losredoe132/h43it/hardware/h43it_micro/h43bit_micro.kicad_pcb

## KiCad design hardware/h43it_micro/h43bit_micro.kicad_pcb (2024-03-31)

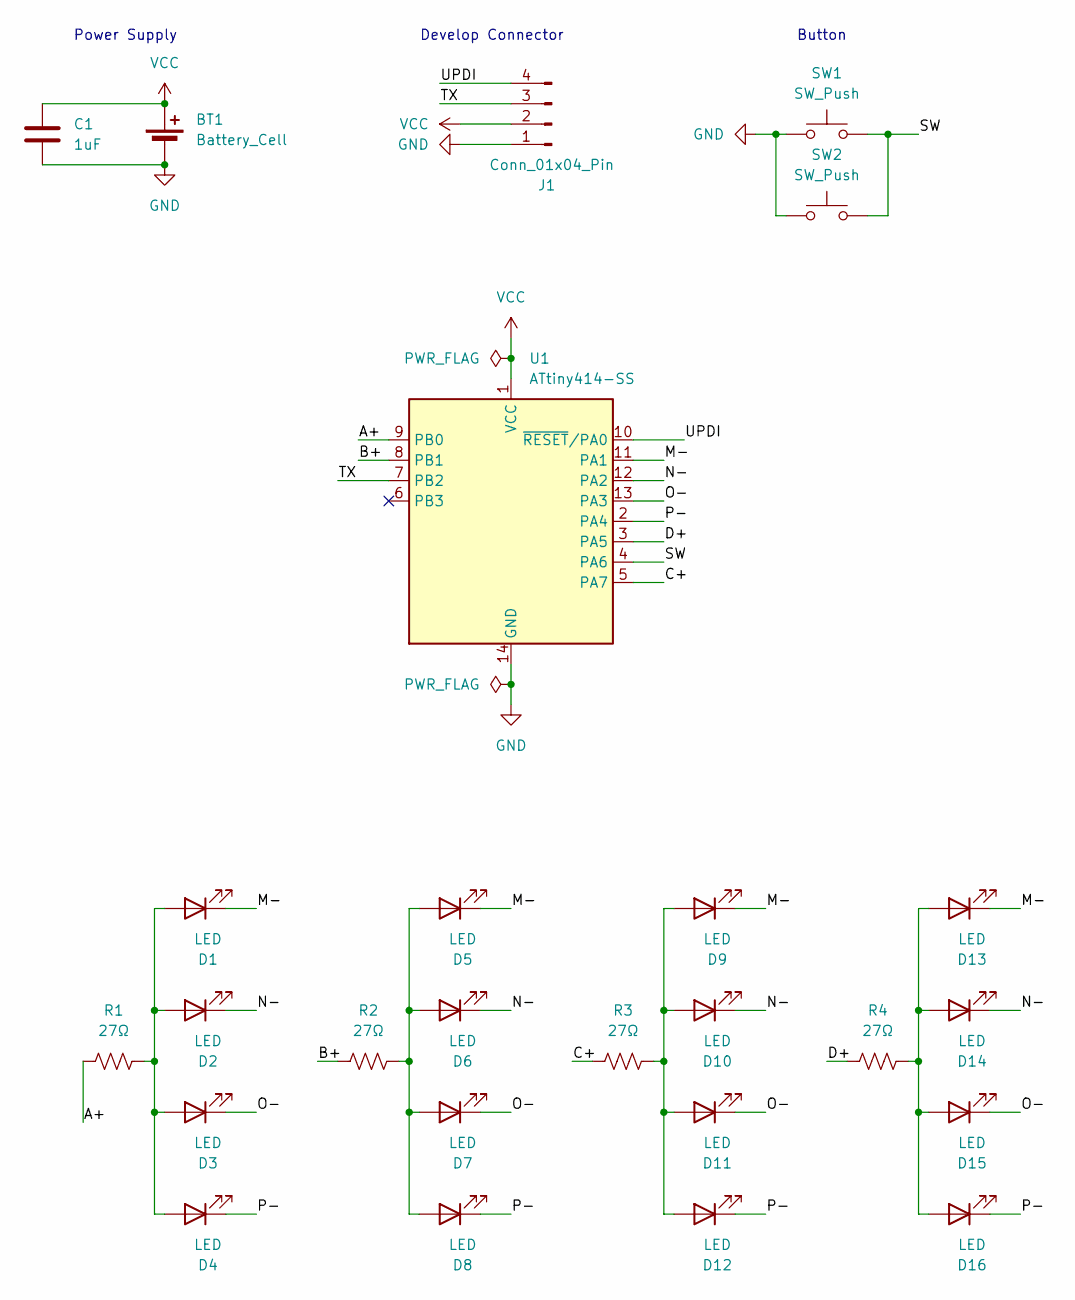
[picture p1: schematic h43bit_micro.kicad_sch]

Parts:
BT1: Battery_Cell; BAT-HLD-001
C1: 1uF; C_0805_2012Metric
D1, D2, D3, D4, D5, D6, D7, D8, D9, D10, D11, D12, D13, D14, D15, D16: LED; LED_0805_2012Metric
J1: Conn_01x04_Pin; PinHeader_1x04_P2.54mm_Vertical
R1, R2, R3, R4: 27Ω; R_0805_2012Metric
SW1: SW_Push; PTS526 SM15 SMTR2 LFS
SW2: SW_Push; FSM2JSMAATR
U1: ATtiny414-SS; SOIC-14_3.9x8.7mm_P1.27mm

Connections:
/A+: R1.1, U1.9 (PB0)
/B+: R2.1, U1.8 (PB1)
/C+: R3.1, U1.5 (PA7)
/D+: R4.1, U1.3 (PA5)
/M-: D1.1 (K), D5.1 (K), D9.1 (K), D13.1 (K), U1.11 (PA1)
/N-: D2.1 (K), D6.1 (K), D10.1 (K), D14.1 (K), U1.12 (PA2)
/O-: D3.1 (K), D7.1 (K), D11.1 (K), D15.1 (K), U1.13 (PA3)
/P-: D4.1 (K), D8.1 (K), D12.1 (K), D16.1 (K), U1.2 (PA4)
/SW: SW1.2, SW2.2, U1.4 (PA6)
/TX: J1.3, U1.7 (PB2)
/UPDI: J1.4, U1.10 (~RESET/PA0)
GND: BT1.2 (-), C1.2, J1.1, SW1.1, SW2.1, U1.14 (GND)
unnamed: D1.2 (A), D2.2 (A), D3.2 (A), D4.2 (A), R1.2
unnamed: D5.2 (A), D6.2 (A), D7.2 (A), D8.2 (A), R2.2
unnamed: D9.2 (A), D10.2 (A), D11.2 (A), D12.2 (A), R3.2
unnamed: D13.2 (A), D14.2 (A), D15.2 (A), D16.2 (A), R4.2
VCC: BT1.1 (+), C1.1, J1.2, U1.1 (VCC)

Notes on the sheet:
Develop Connector
Power Supply
Button

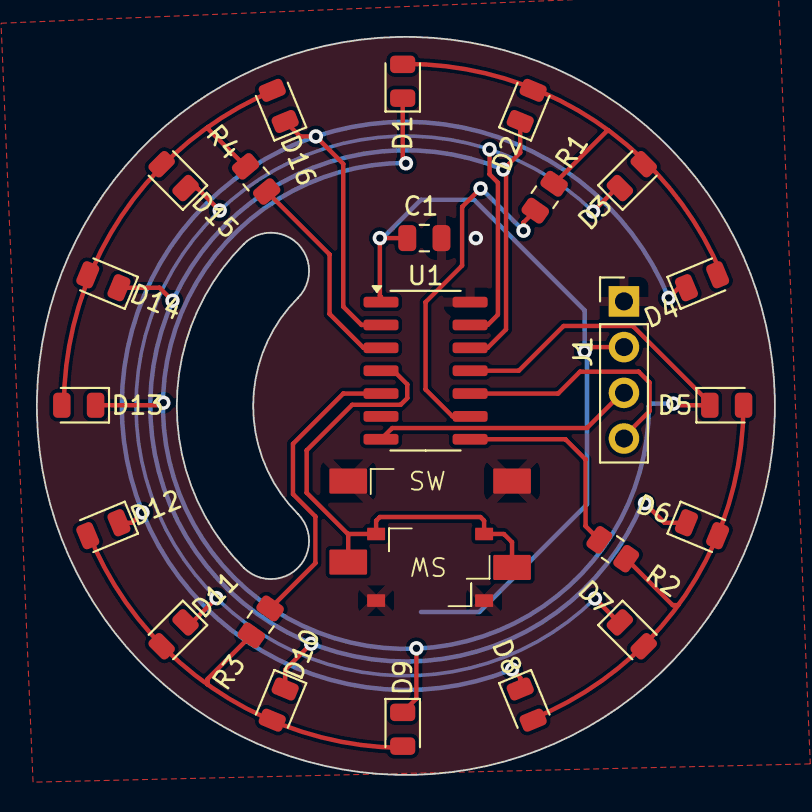
[picture p2: board h43bit_micro.kicad_pcb from above]

Board: 2 copper layers, 41.0 x 41.0 mm, 26 parts (1 on the bottom side), 17 nets.
