losredoe132/h43it/hardware/h43it_macro/h43it_macro.kicad_pcb

## KiCad design hardware/h43it_macro/h43it_macro.kicad_pcb (2024-03-28)

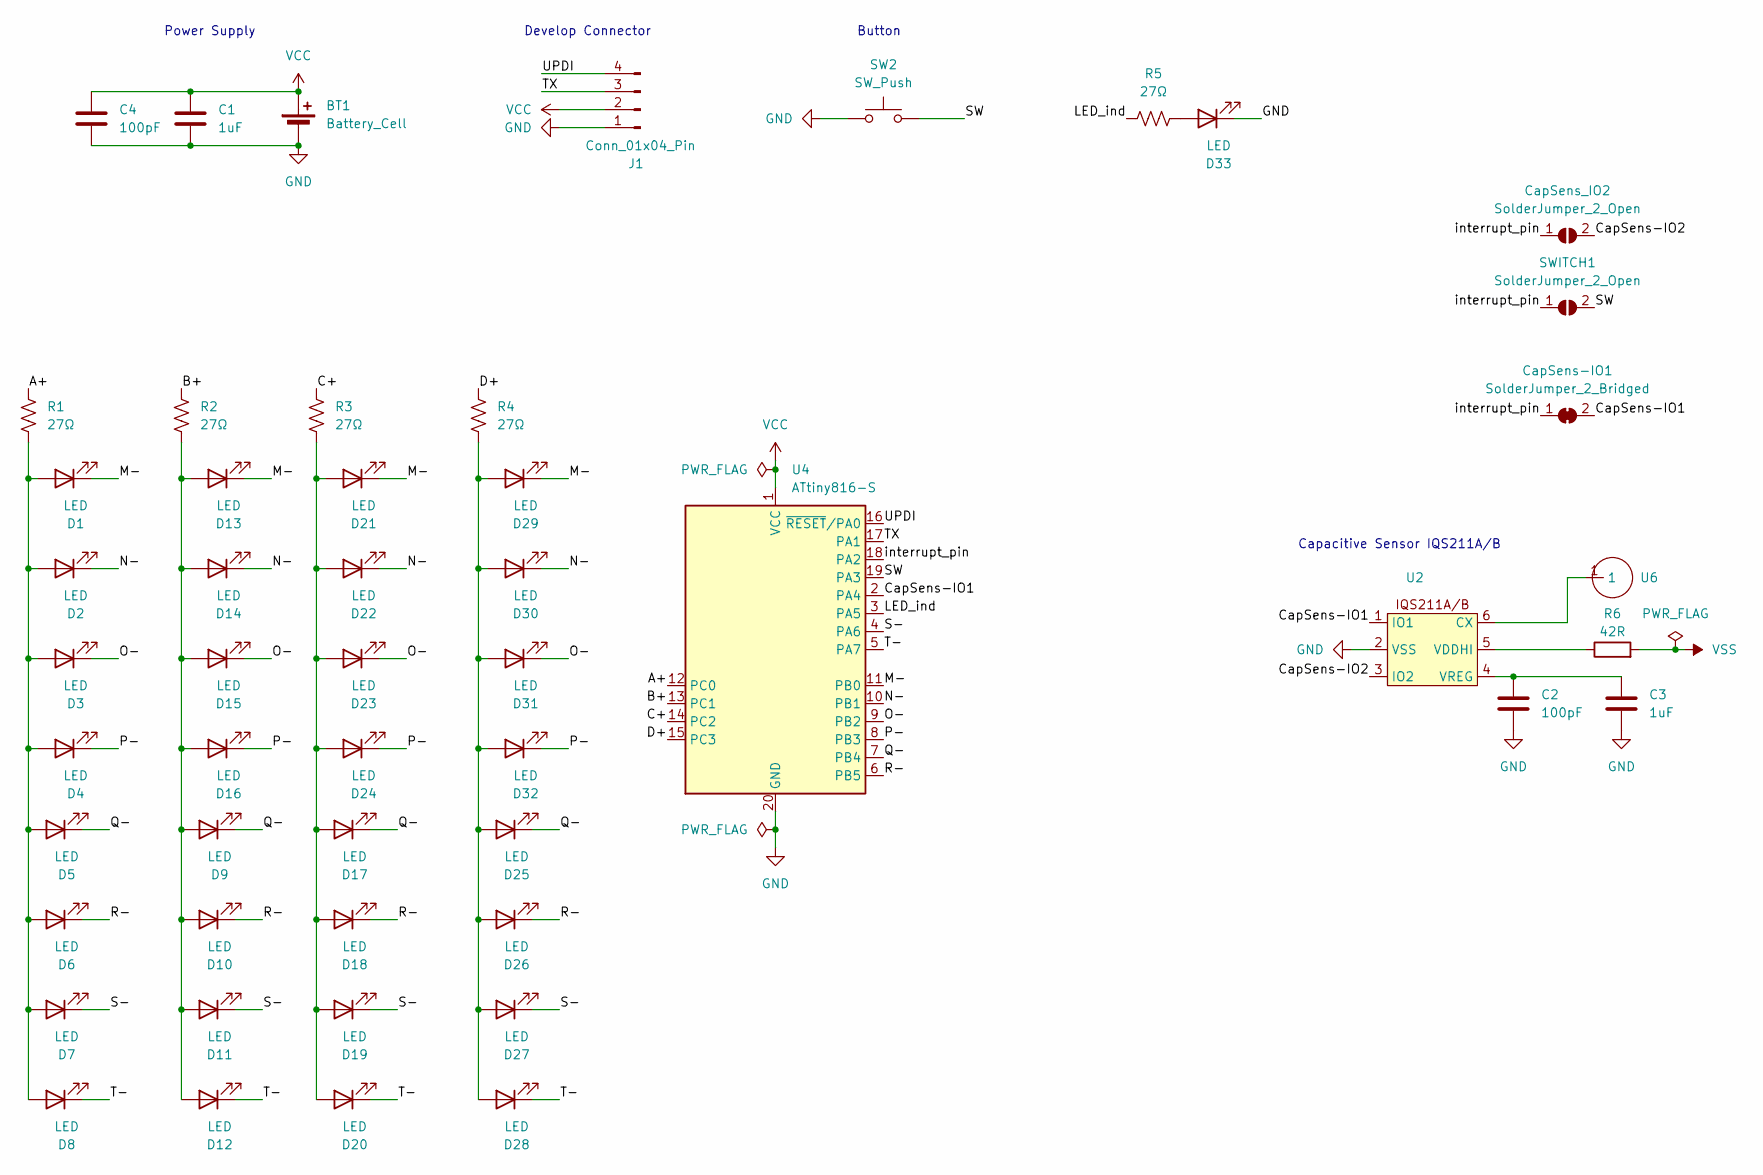
[picture p3: schematic h43it_macro.kicad_sch]

Parts:
BT1: Battery_Cell; Battery_holder__Keystone_Electronic_AA_2462
C1, C3: 1uF; C_0805_2012Metric
C2, C4: 100pF; C_0805_2012Metric
CapSens-IO1: SolderJumper_2_Bridged; SolderJumper-2_P1.3mm_Bridged_RoundedPad1.0x1.5mm
CapSens_IO2: SolderJumper_2_Open; SolderJumper-2_P1.3mm_Open_RoundedPad1.0x1.5mm
D1, D2, D3, D4, D5, D6, D7, D8, D9, D10, D11, D12, D13, D14, D15, D16, D17, D18, D19, D20, D21, D22, D23, D24, D25, D26, D27, D28, D29, D30, D31, D32, D33: LED; LED_0805_2012Metric
J1: Conn_01x04_Pin; PinHeader_1x04_P2.54mm_Vertical
R1, R2, R3, R4, R5: 27Ω; R_0805_2012Metric
R6: 42R; R_0805_2012Metric
SW2: SW_Push; FSM2JSMAATR
SWITCH1: SolderJumper_2_Open; SolderJumper-2_P1.3mm_Open_RoundedPad1.0x1.5mm
U2: TSOT32-6
U4: ATtiny816-S; SOIC-20W_7.5x12.8mm_P1.27mm
U6: TouchButton-15x10mm

Connections:
/A+: R1.2, U4.12 (PC0)
/B+: R2.2, U4.13 (PC1)
/C+: R3.2, U4.14 (PC2)
/CapSens-IO1: CapSens-IO1.2 (B), U2.1 (IO1), U4.2 (PA4)
/CapSens-IO2: CapSens_IO2.2 (B), U2.3 (IO2)
/D+: R4.2, U4.15 (PC3)
/LED_ind: R5.2, U4.3 (PA5)
/M-: D1.1 (K), D13.1 (K), D21.1 (K), D29.1 (K), U4.11 (PB0)
/N-: D2.1 (K), D14.1 (K), D22.1 (K), D30.1 (K), U4.10 (PB1)
/O-: D3.1 (K), D15.1 (K), D23.1 (K), D31.1 (K), U4.9 (PB2)
/P-: D4.1 (K), D16.1 (K), D24.1 (K), D32.1 (K), U4.8 (PB3)
/Q-: D5.1 (K), D9.1 (K), D17.1 (K), D25.1 (K), U4.7 (PB4)
/R-: D6.1 (K), D10.1 (K), D18.1 (K), D26.1 (K), U4.6 (PB5)
/S-: D7.1 (K), D11.1 (K), D19.1 (K), D27.1 (K), U4.4 (PA6)
/SW: SW2.2, SWITCH1.2 (B), U4.19 (PA3)
/T-: D8.1 (K), D12.1 (K), D20.1 (K), D28.1 (K), U4.5 (PA7)
/TX: J1.3, U4.17 (PA1)
/UPDI: J1.4, U4.16 (~RESET/PA0)
/interrupt_pin: CapSens-IO1.1 (A), CapSens_IO2.1 (A), SWITCH1.1 (A), U4.18 (PA2)
GND: BT1.2 (-), C1.2, C2.2, C3.2, C4.2, D33.1 (K), J1.1, SW2.1, U2.2 (VSS), U4.20 (GND)
unnamed: D1.2 (A), D2.2 (A), D3.2 (A), D4.2 (A), D5.2 (A), D6.2 (A), D7.2 (A), D8.2 (A), R1.1
unnamed: D9.2 (A), D10.2 (A), D11.2 (A), D12.2 (A), D13.2 (A), D14.2 (A), D15.2 (A), D16.2 (A), R2.1
unnamed: D17.2 (A), D18.2 (A), D19.2 (A), D20.2 (A), D21.2 (A), D22.2 (A), D23.2 (A), D24.2 (A), R3.1
unnamed: D25.2 (A), D26.2 (A), D27.2 (A), D28.2 (A), D29.2 (A), D30.2 (A), D31.2 (A), D32.2 (A), R4.1
unnamed: D33.2 (A), R5.1
unnamed: U2.6 (CX), U6.1
unnamed: R6.1, U2.5 (VDDHI)
unnamed: C2.1, C3.1, U2.4 (VREG)
VCC: BT1.1 (+), C1.1, C4.1, J1.2, U4.1 (VCC)
VSS: R6.2

Notes on the sheet:
Button
Power Supply
Capacitive Sensor IQS211A/B
Develop Connector

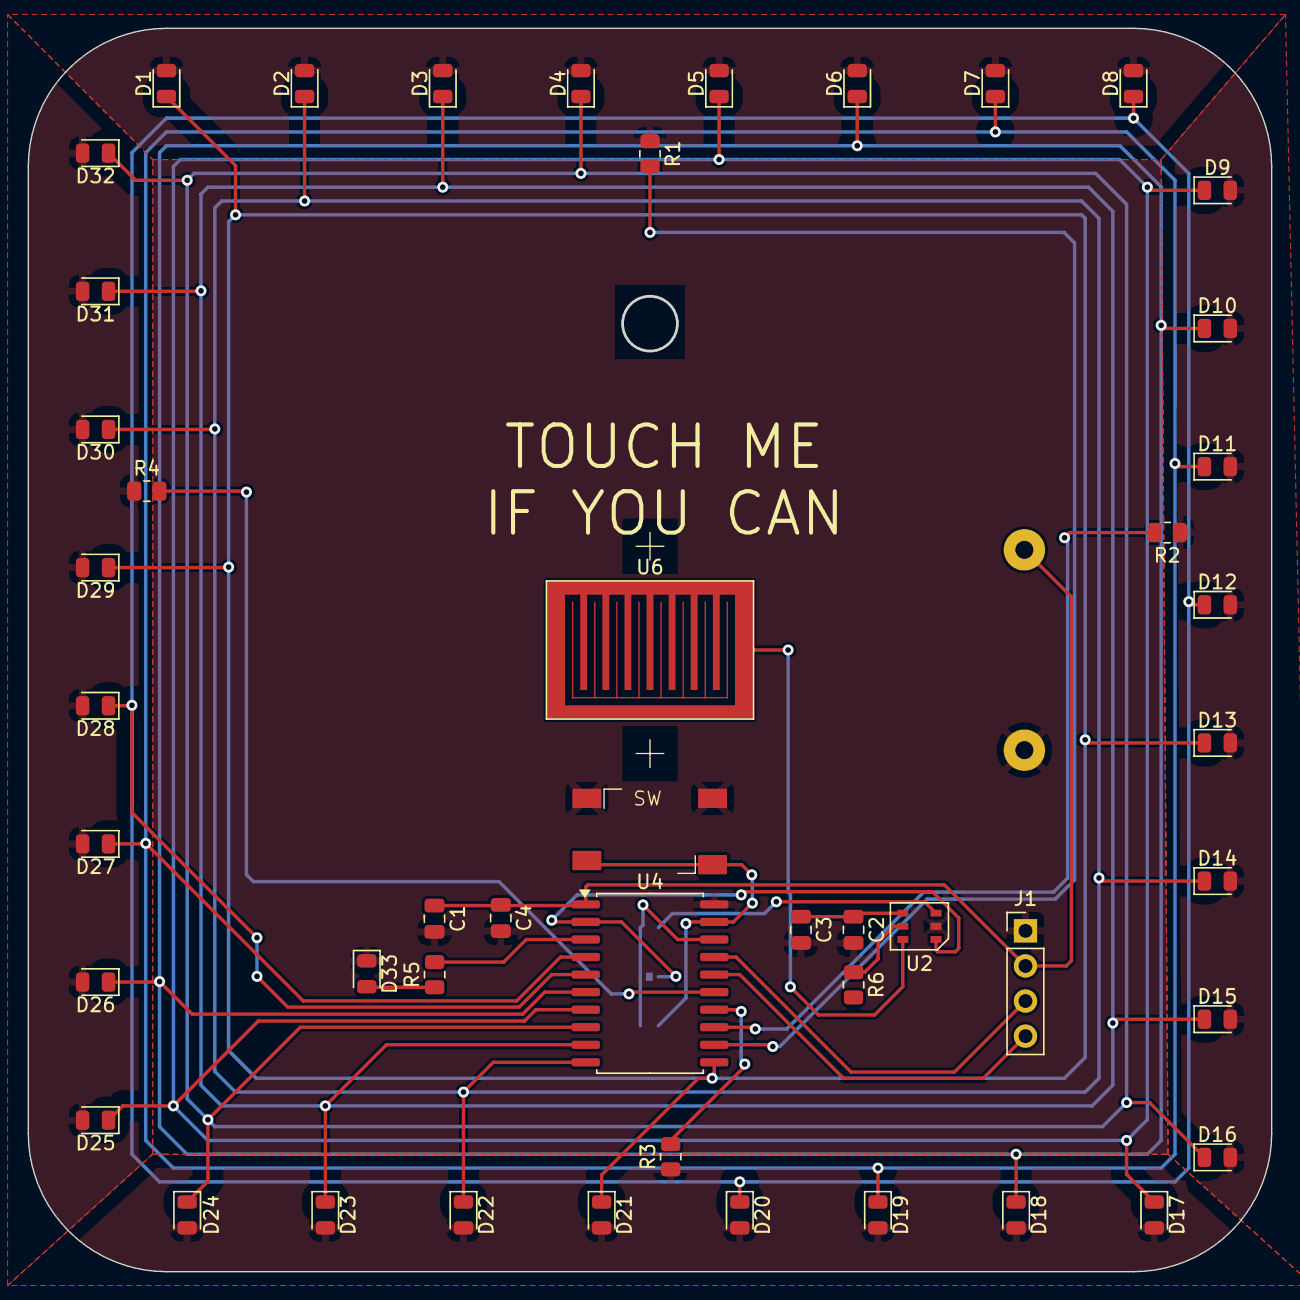
[picture p4: board h43it_macro.kicad_pcb from above]

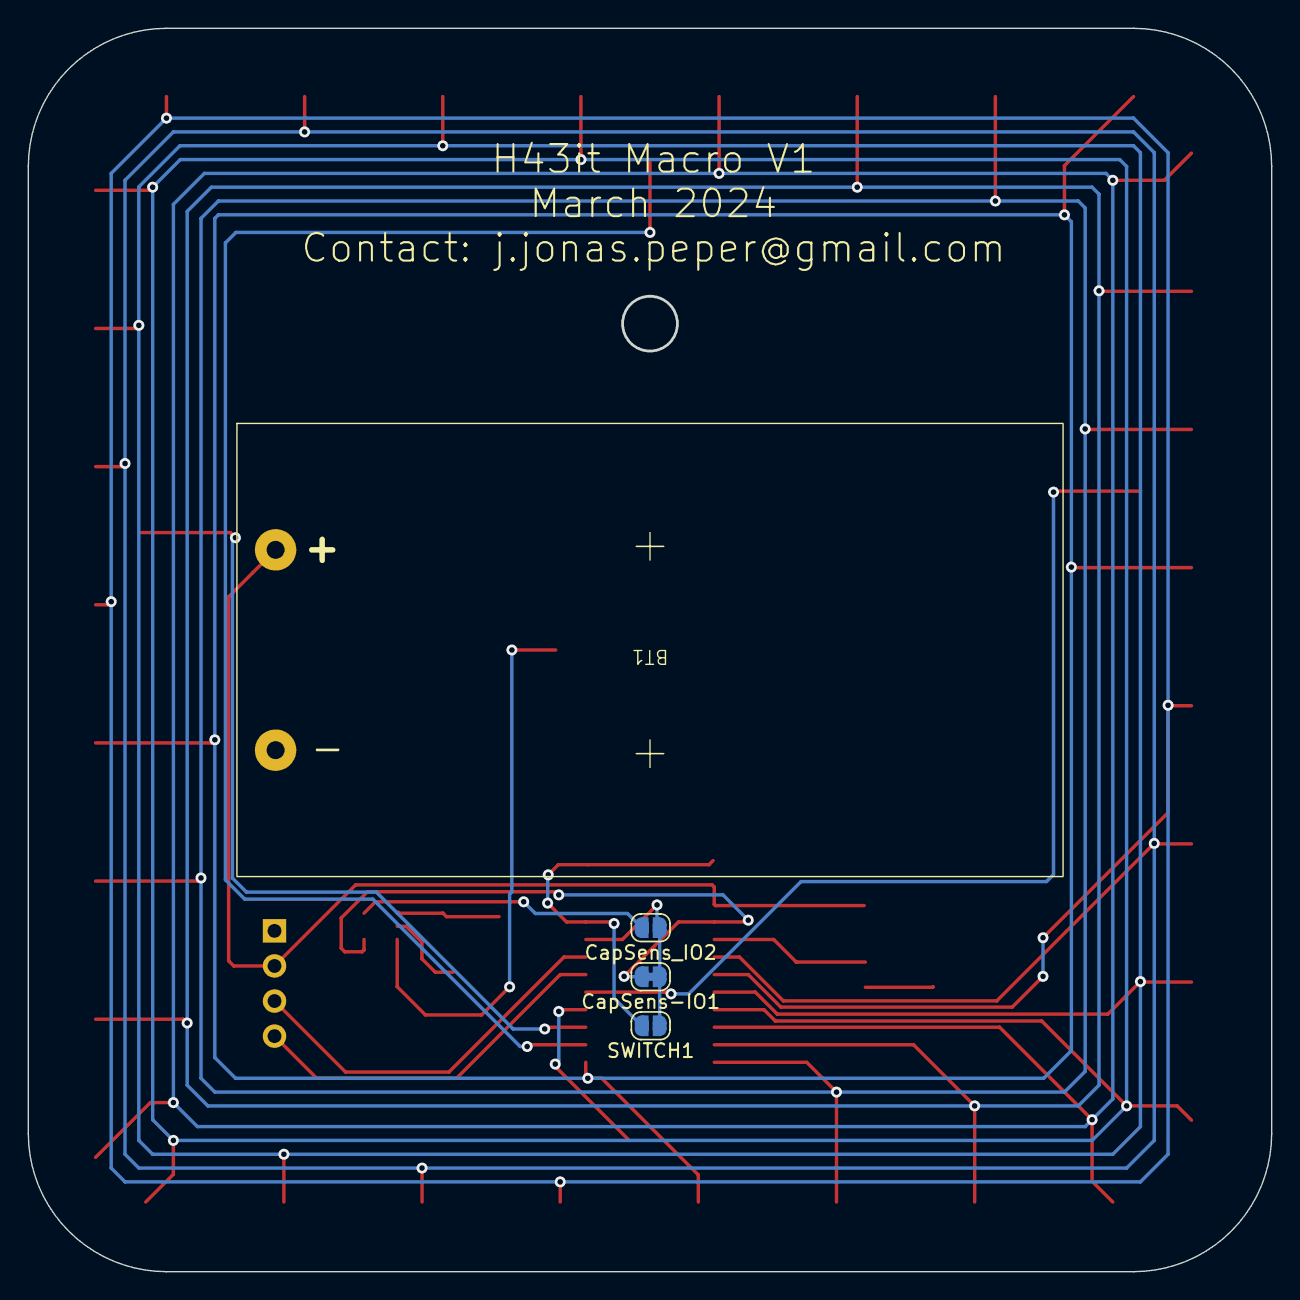
[picture p5: board h43it_macro.kicad_pcb from below]

Board: 2 copper layers, 90.0 x 90.0 mm, 52 parts (4 on the bottom side), 29 nets.
