losredoe132/h43it/(threads)

Thread 1 (2024-03-28):

add light_on variable

losredoe132, 2024-03-28:
the ISR for the RTC triggers a wake up approx. every 30s. This leads to a very short blink and sometimes to one LED remain on even if the µC is going to sleep.
Introduce a variable that prevents the LEDs from going on everytime the µC is awake.

Thread 3 (2024-07-29):

Use the status LED

losredoe132, 2024-07-29:
- solder resistor and LED
- implement RESET LED
