losredoe132/h43it/software/macro/GccApplication5/include/transition_conditions.c

bool pred_button_push_long()
{
	if (consecutive_counts_pressed > 100)
	{
		return true;
	}
	else
	{
		return false;
	}
}

bool pred_button_push_short()
{
	if (consecutive_counts_pressed > 2)
	{
		return true;
	}
	else
	{
		return false;
	}
}

bool pred_button_released()
{
	if (consecutive_counts_released > 2)
	{
		return true;
	}
	else
	{
		return false;
	}
}

bool pred_tired()
{
	if (n_counts_awake > 50)
	{
		return true;
	}
	else
	{
		return false;
	}
}

bool pred_true()
{
	return true;
}

bool pred_ISRs()
{
	// This is not an actual condition but handled by the Interrupt Service Routines to be
	// wake up from sleep if a button gets pressed or the Periodic Interrupt Routine is firing.
	return true;
}

bool pred_is_PIT_ISR()
{
	if (is_PIT_ISR == 1)
	{
		return true;
	}
	else
	{
		return false;
	}
}

bool pred_is_button_ISR()
{
	if (is_PIT_ISR == 0)
	{
		return true;
	}
	else
	{
		return false;
	}
}
