losredoe132/h43it/software/macro/GccApplication5/include/transition_table.c

State  Activation ,   GoingToBed ,   Idle ,   Init ,   JustWokeUp ,   PIT ,   Reset ,   WaitUntilRelease  ;

// Define transitions for each state

Transition ActivationTransitions[] = {
    
    { &Idle, pred_button_released} ,  
    
    { &Reset, pred_button_push_long}  
    
};
Transition GoingToBedTransitions[] = {
    
    { &JustWokeUp, pred_ISRs}  
    
};
Transition IdleTransitions[] = {
    
    { &Activation, pred_button_push_short} ,  
    
    { &GoingToBed, pred_tired} ,  
    
    { &Idle, pred_true}  
    
};
Transition InitTransitions[] = {
    
    { &Reset, pred_button_released}  
    
};
Transition JustWokeUpTransitions[] = {
    
    { &WaitUntilRelease, pred_is_button_ISR} ,  
    
    { &PIT, pred_is_PIT_ISR}  
    
};
Transition PITTransitions[] = {
    
    { &GoingToBed, pred_true}  
    
};
Transition ResetTransitions[] = {
    
    { &Idle, pred_button_released}  
    
};
Transition WaitUntilReleaseTransitions[] = {
    
    { &Idle, pred_button_released}  
    
};

// Define states with transitions

State Activation = { "Activation", ActivationAction, ActivationTransitions, 2 };

State GoingToBed = { "GoingToBed", GoingToBedAction, GoingToBedTransitions, 1 };

State Idle = { "Idle", IdleAction, IdleTransitions, 3 };

State Init = { "Init", InitAction, InitTransitions, 1 };

State JustWokeUp = { "JustWokeUp", JustWokeUpAction, JustWokeUpTransitions, 2 };

State PIT = { "PIT", PITAction, PITTransitions, 1 };

State Reset = { "Reset", ResetAction, ResetTransitions, 1 };

State WaitUntilRelease = { "WaitUntilRelease", WaitUntilReleaseAction, WaitUntilReleaseTransitions, 1 };
