losredoe132/h43it/software/macro/GccApplication5/include/led_pins.c

const uint8_t port_a_b_c_outs[33][3] = {
	// TSxxxxxx,0bxxRQPONM, 0bxxxxDCBA
	{0b11000000, 0b00111111, 0b00000000}, // ALL OFF

	{0b11000000, 0b11111110, 0b00000001},
	{0b11000000, 0b11111101, 0b00000001},
	{0b11000000, 0b11111011, 0b00000001},
	{0b11000000, 0b11110111, 0b00000001},
	{0b11000000, 0b11101111, 0b00000001},
	{0b11000000, 0b11011111, 0b00000001},
	{0b10000000, 0b11111111, 0b00000001},
	{0b01000000, 0b11111111, 0b00000001},

	{0b11000000, 0b11101111, 0b00000010},
	{0b11000000, 0b11011111, 0b00000010},
	{0b10000000, 0b11111111, 0b00000010},
	{0b01000000, 0b11111111, 0b00000010},
	{0b11000000, 0b11111110, 0b00000010},
	{0b11000000, 0b11111101, 0b00000010},
	{0b11000000, 0b11111011, 0b00000010},
	{0b11000000, 0b11110111, 0b00000010},

	{0b11000000, 0b11101111, 0b00000100},
	{0b11000000, 0b11011111, 0b00000100},
	{0b10000000, 0b11111111, 0b00000100},
	{0b01000000, 0b11111111, 0b00000100},
	{0b11000000, 0b11111110, 0b00000100},
	{0b11000000, 0b11111101, 0b00000100},
	{0b11000000, 0b11111011, 0b00000100},
	{0b11000000, 0b11110111, 0b00000100},

	{0b11000000, 0b11101111, 0b00001000},
	{0b11000000, 0b11011111, 0b00001000},
	{0b10000000, 0b11111111, 0b00001000},
	{0b01000000, 0b11111111, 0b00001000},
	{0b11000000, 0b11111110, 0b00001000},
	{0b11000000, 0b11111101, 0b00001000},
	{0b11000000, 0b11111011, 0b00001000},
	{0b11000000, 0b11110111, 0b00001000},

};

void LEDOnById(int i)
{
	PORTA.OUT = port_a_b_c_outs[i][0];
	PORTB.OUT = port_a_b_c_outs[i][1];
	PORTC.OUT = port_a_b_c_outs[i][2];
}

void allLEDoff()
{
	PORTA.OUT = port_a_b_c_outs[0][0];
	PORTB.OUT = port_a_b_c_outs[0][1];
	PORTC.OUT = port_a_b_c_outs[0][2];
}


void statusLEDon(){
	PORTA.OUTSET = 0b00100000;
}


void statusLEDoff(){
	PORTA.OUTSET = 0b00000000;
}
