losredoe132/h43it/(commit log)

2024-02-14 working printf command
2024-02-17 working button and led
2024-02-24 all LEDs working in double for loop
2024-02-24 2d array for all leds
2024-02-24 working button
2024-02-26 working button example
2024-02-27 working RTC timer
2024-02-27 using timer and pin interrupt in parallel
2024-02-28 working peripdic awakening but only in idle not power down
2024-02-29 fixed last brightest bug
    [main.c]
2024-02-29 working PIT with POWER DOWN
2024-03-01 increasing by long button press
2024-03-02 working sleep and robust button commands
2024-03-02 working sleep and robust button command even with PWR DOWN
2024-03-02 fix dont want to go to sleep bug
    [main.c]
2024-03-02 working reset and forbiden increase
    [main.c]
2024-03-09 resturcture and add gitignore for hardware and software dev
    [h43bit_micro.kicad_pcb, h43bit_micro.kicad_sch]
2024-03-09 first draft of schematic
    [h43bit_micro.kicad_pcb, h43bit_micro.kicad_sch]
2024-03-09 draft of a circular micro
    [h43bit_micro.kicad_pcb]
2024-03-10 circular tracks
    [h43bit_micro.kicad_pcb, h43bit_micro.kicad_sch]
2024-03-11 filled area
    [h43bit_micro.kicad_pcb, h43bit_micro.kicad_sch]
2024-03-11 fill with smaller clearence to incorperate all areas at top
    [h43bit_micro.kicad_pcb]
2024-03-12 first draft of a finished pcb
    [h43bit_micro.kicad_pcb, h43bit_micro.kicad_sch]
2024-03-13 add macro pcb project
    [h43bit_micro.kicad_pcb, h43it_macro.kicad_pcb, h43it_macro.kicad_sch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]
2024-03-13 schematic draft finsihed
    [h43it_macro.kicad_sch]
2024-03-18 add twin attiny 816
    [h43it_macro.kicad_pcb, h43it_macro.kicad_sch]
2024-03-24 pcb for macro
    [h43it_macro.kicad_pcb, h43it_macro.kicad_sch]
2024-03-24 pcb for macro 2
    [h43it_macro.kicad_pcb]
2024-03-24 pcb for macro 3
    [h43it_macro.kicad_pcb, h43it_macro.kicad_sch]
2024-03-24 pcb for macro 4
    [h43it_macro.kicad_pcb]
2024-03-26 tiny changes and added R6
    [h43it_macro.kicad_pcb, h43it_macro.kicad_sch]
2024-03-28 switch SW on micro
    [h43bit_micro.kicad_pcb, h43bit_micro.kicad_sch]
2024-03-28 no errors in macro
    [h43it_macro.kicad_pcb]
2024-03-28 no errors in micro
    [h43bit_micro.kicad_pcb]
2024-03-28 recreate production files
    [h43bit_micro.kicad_pcb]
2024-03-31 success all DRC
    [h43bit_micro.kicad_pcb]
2024-04-12 add macro code
    [h43it_macro.kicad_sch]
2024-07-26 fully functional 2 state FSM with button as condition
2024-07-26 tiny led 2 state demo
2024-07-27 working FSM code generation - with some bugfixes
    [main.c, state_actions.c, transition_conditions.c, transition_table.c]
2024-07-27 working button conditions
2024-07-28 working sleep with wake up on button
2024-07-28 working prototype macro
2024-07-28 time counting only in PIT wirhout missedActivation state
    [main.c, state_actions.c, system_init.c, transition_conditions.c, transition_table.c]
2024-07-28 added daycounter to prevent overflow and set newday to 24h
    [main.c, state_actions.c, system_init.c]
2024-08-01 get status led running
2024-08-01 added init state to check leds are working after power up
